EmilioPeJu/d2tsf-hw/3d/EPL.00.250.NTN.step

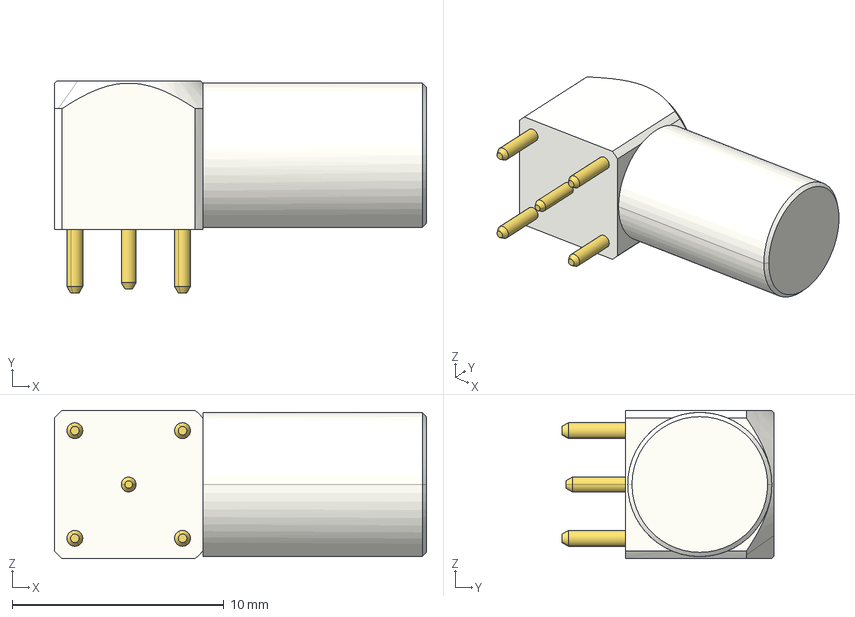
[picture p2: CAD file, 2022-11-08]
3d/EPL.00.250.NTN.step
17.6 x 10.0 x 7.00 mm
