EmilioPeJu/d2tsf-hw/3d/SN74LVC8T245PWR.step

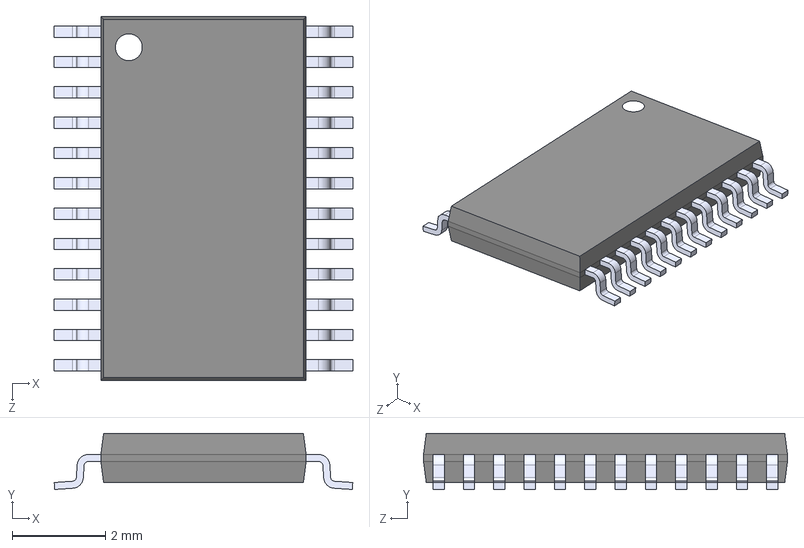
[picture p3: CAD file, 2022-11-08]
3d/SN74LVC8T245PWR.step
6.40 x 1.20 x 7.80 mm
