EmilioPeJu/d2tsf-hw/d2tsf-hw-revB.pdf

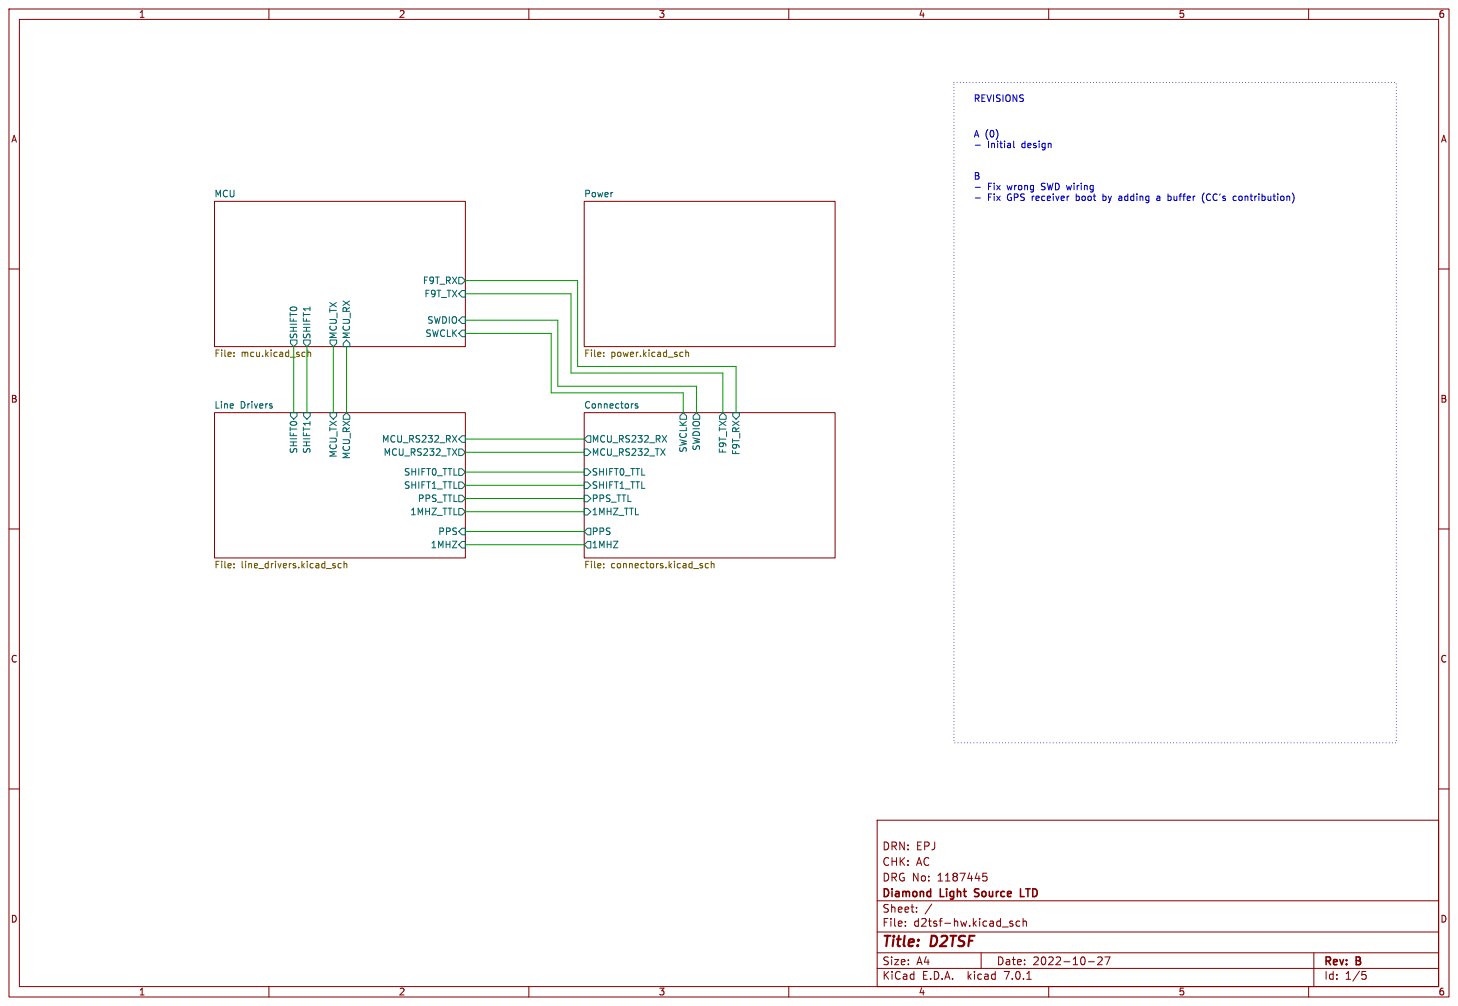
[picture p4: page 1]

- Fix wrong SWD wiring
- Fix GPS receiver boot by adding a buffer (CC's contribution)

DRG No: 1187445 CHK: AC

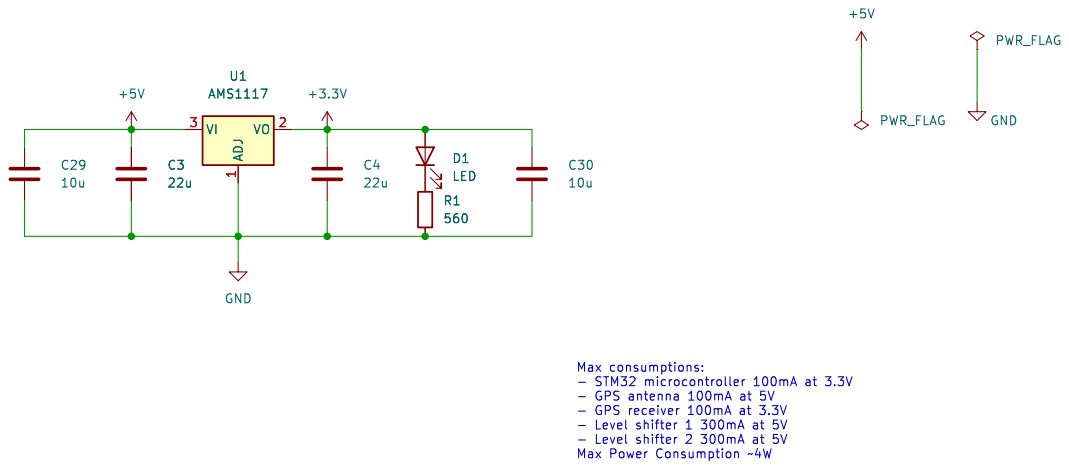
[picture p5: page 2]

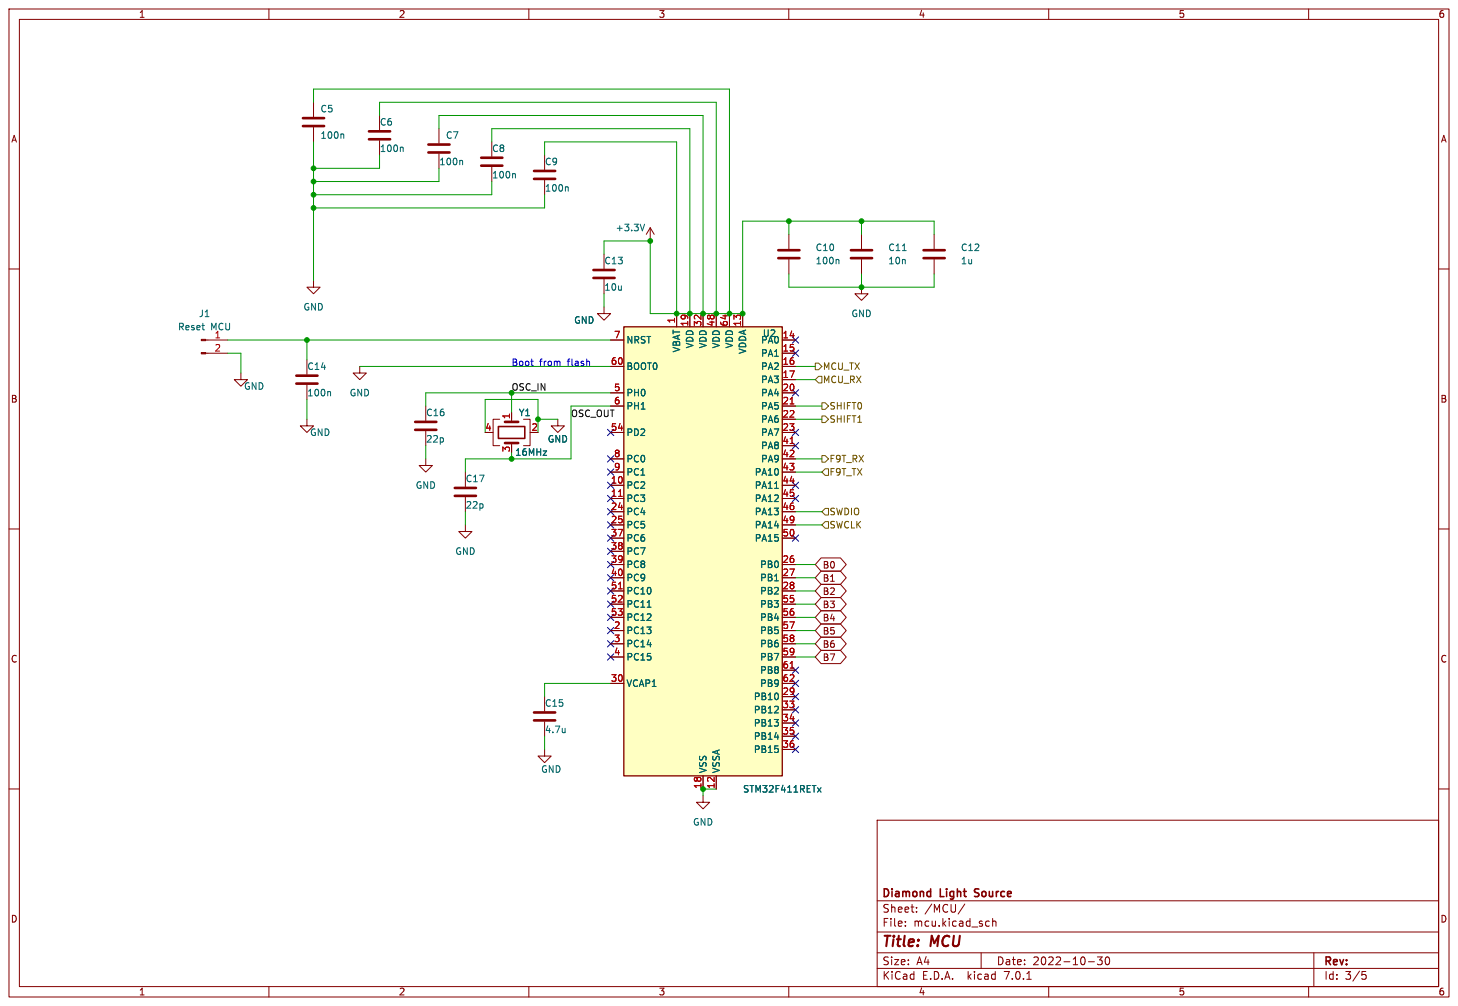
[picture p6: page 3]

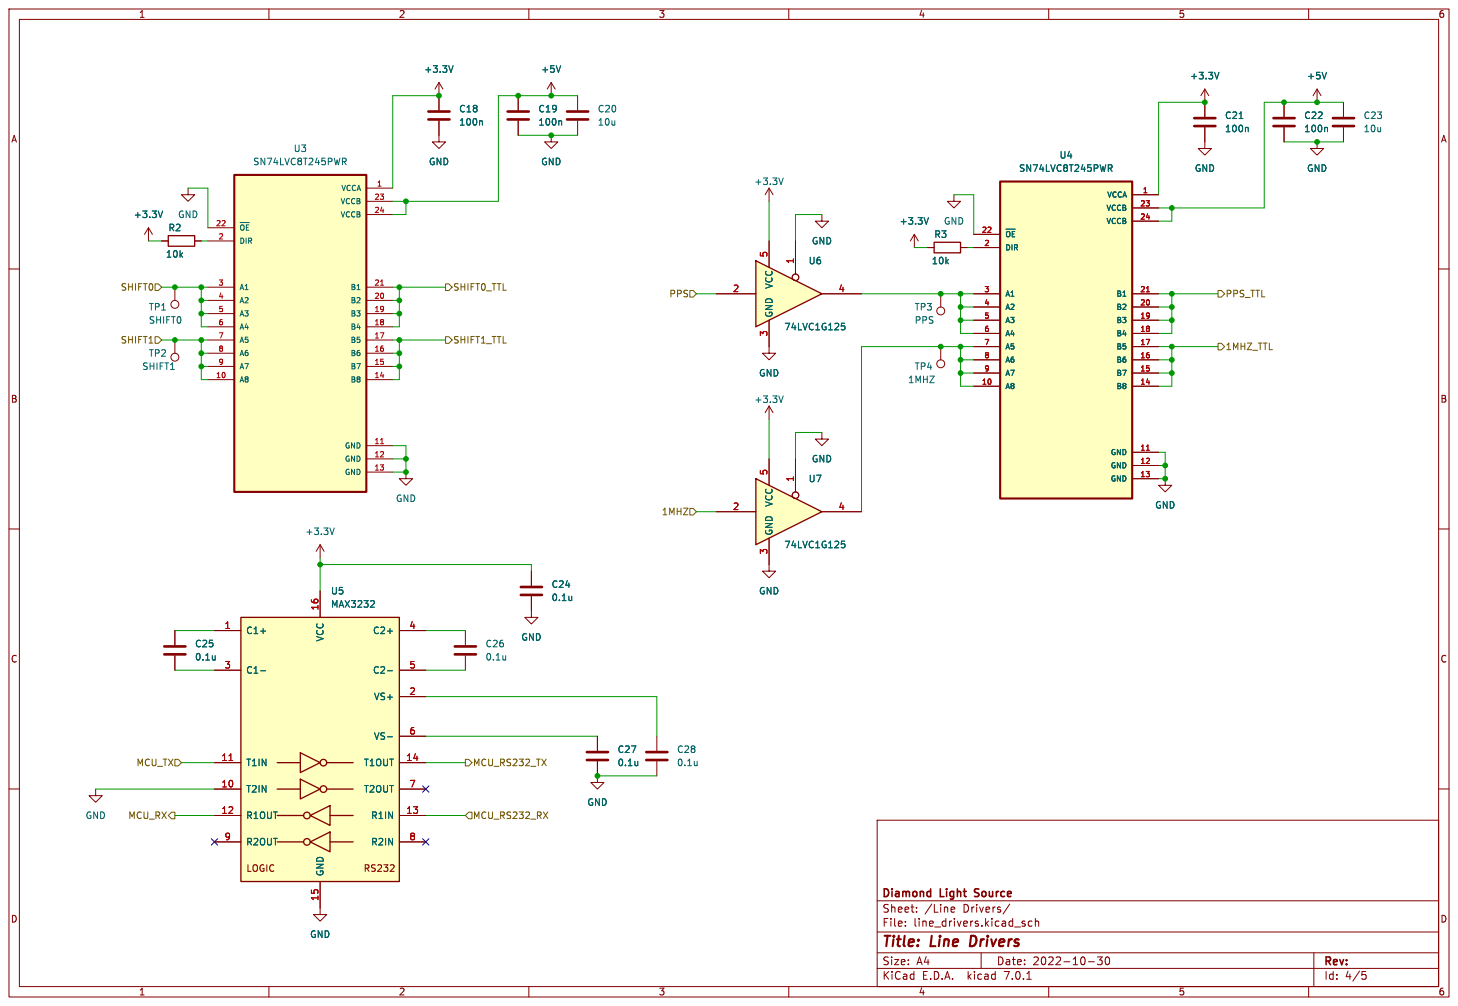
[picture p7: page 4]

Id: 4/5 Title: Line Drivers

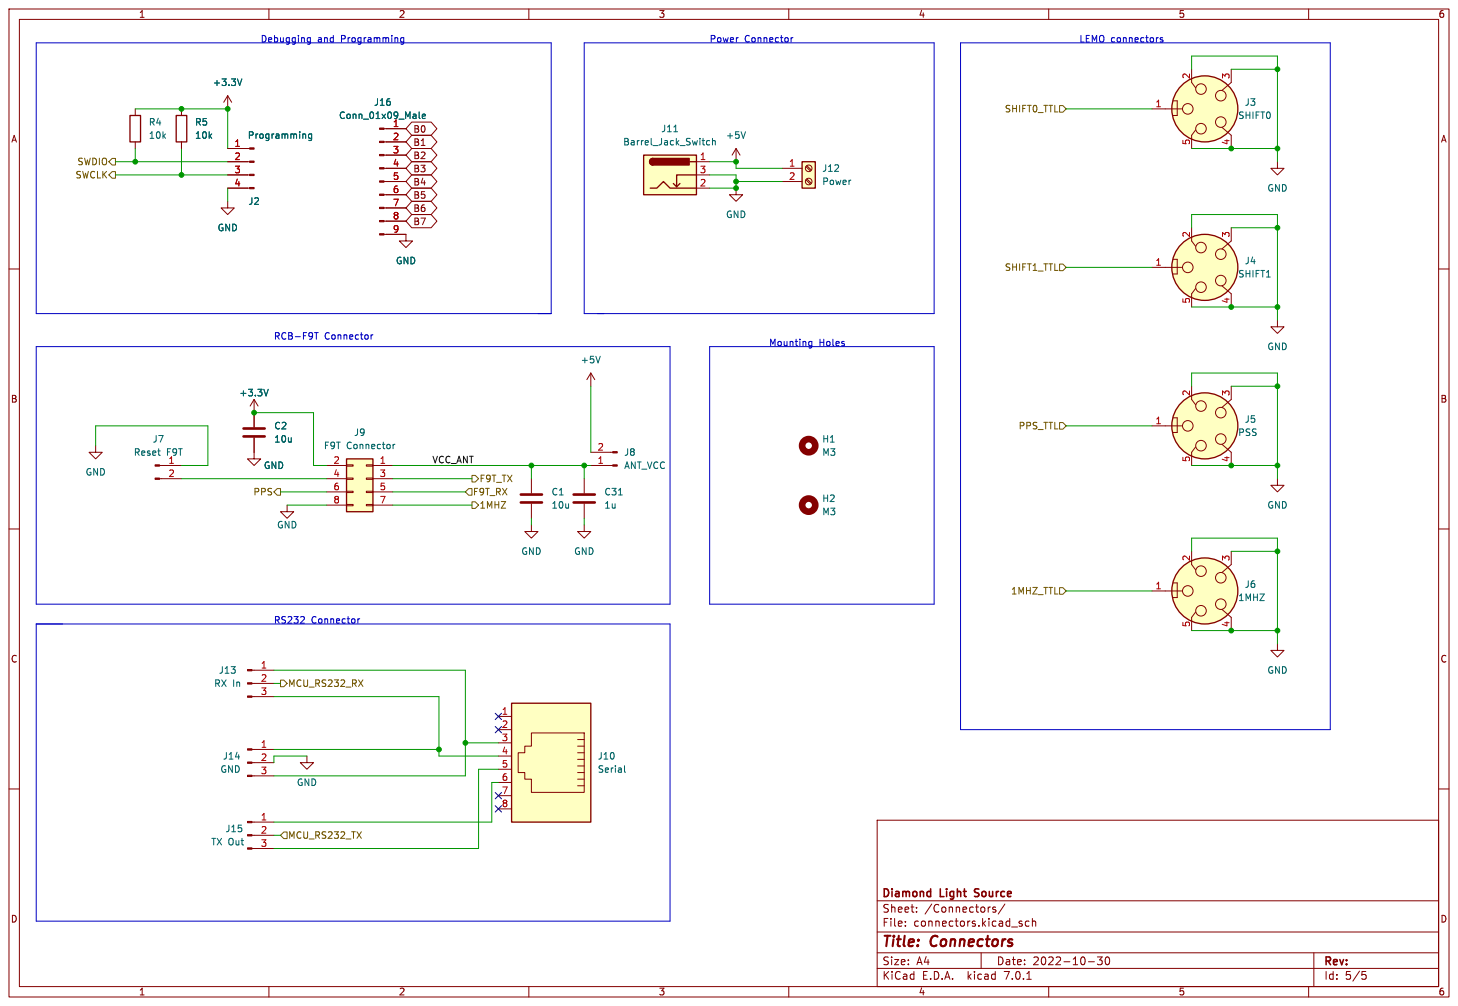
[picture p8: page 5]
