EmilioPeJu/d2tsf-hw/(commit log)

2022-11-08 Change to use 4 layers
    - In1 is GND layer
    - In2 is 3.3V layer
    - Additionally, a few test points were added
    [connectors.kicad_sch, d2tsf-hw.kicad_pcb, d2tsf-hw.kicad_sch, line_drivers.kicad_sch, mcu.kicad_sch]
2022-11-08 Increase clearance from mounting hole
    [d2tsf-hw.kicad_pcb]
2022-11-21 Add initial BOM and gerber files
    [d2tsf-hw-bom.csv]
2022-11-21 Update schematic plot
2022-11-21 Move pin 1 indicator closer to pin
    [d2tsf-hw.kicad_pcb]
2022-11-24 Annotate connectors
    [d2tsf-hw.kicad_pcb]
2022-11-24 Fix inverse numbering of programming header
    [connectors.kicad_sch, d2tsf-hw.kicad_pcb]
2022-11-28 Fix wrong connection of SWD pins
    [d2tsf-hw.kicad_pcb, line_drivers.kicad_sch, mcu.kicad_sch]
2022-12-02 Release board rev1
    Ferrite bead 1 was removed (not needed)
    [connectors.kicad_sch, d2tsf-hw.kicad_pcb, d2tsf-hw.kicad_sch]
2022-12-09 Add pull up resistors to SWD signals
    [connectors.kicad_sch, d2tsf-hw.kicad_pcb, d2tsf-hw.kicad_sch]
2023-01-05 Mark microcontroller pin 1 on silkscreen
    [d2tsf-hw.kicad_pcb]
2023-02-16 Convert to KiCad 7 format
    [connectors.kicad_sch, d2tsf-hw.kicad_pcb, d2tsf-hw.kicad_sch, line_drivers.kicad_sch, mcu.kicad_sch, power.kicad_sch]
2023-02-22 Rev3: Fix GPS receiver start problem and update to KiCad 7
    - Pin TP2 of GPS receiver seems to be pulled down briefly at start time,
    this triggers the safe boot mode. A buffer was added to address this
    issue. Thanks Chris C. for the fix and thanks Paul H. for the
    investigation
    - All files were adapted to KiCad 7 format and many symbols and footprints
    were replaced with newer ones.
    [connectors.kicad_sch, d2tsf-hw-bom.csv, d2tsf-hw-rev2.csv, d2tsf-hw.kicad_pcb, d2tsf-hw.kicad_sch, line_drivers.kicad_sch, mcu.kicad_sch, power.kicad_sch]
2023-03-20 Add metadata to follow Diamond's standard and use a letter for the revision
    [d2tsf-hw-rev2.csv, d2tsf-hw-revB.csv, d2tsf-hw.kicad_pcb, d2tsf-hw.kicad_sch]
